gabriel-ruffo/skittle-sorter/tube.SLDPRT

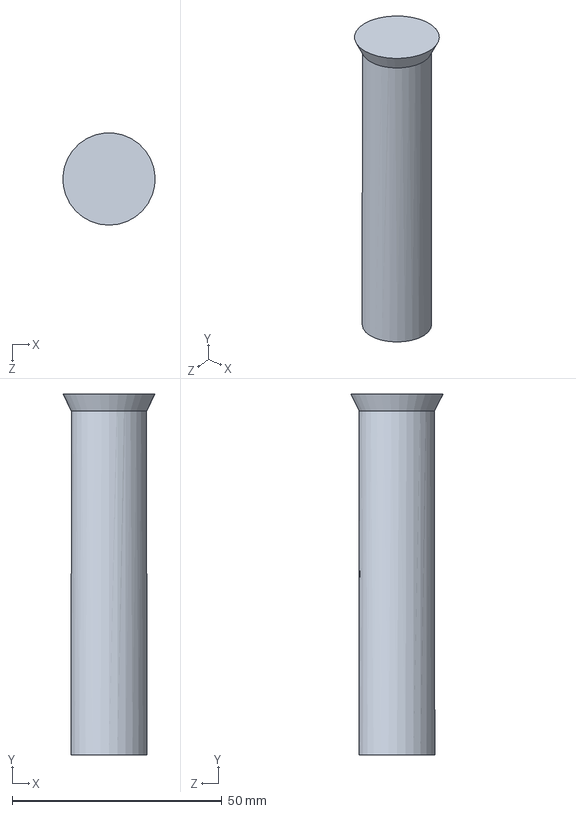
[picture p19: CAD file, 2020-01-24]
tube.SLDPRT
22.0 x 86.0 x 22.0 mm
