gabriel-ruffo/skittle-sorter/servoArmLong.SLDPRT

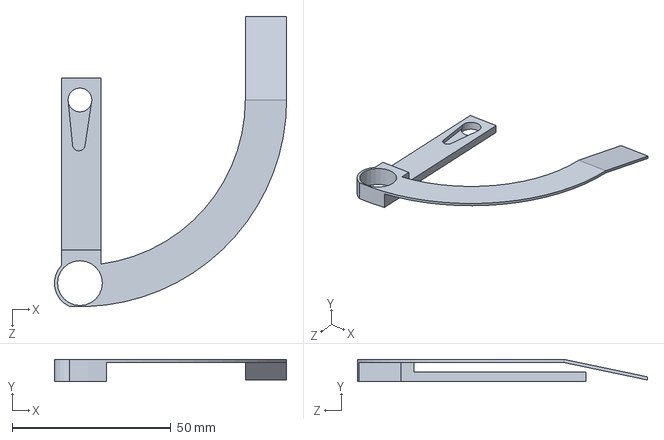
[picture p20: CAD file, 2020-01-24]
servoArmLong.SLDPRT
73.0 x 7.00 x 91.2 mm
