gabriel-ruffo/skittle-sorter/bottomPlateLong.SLDPRT

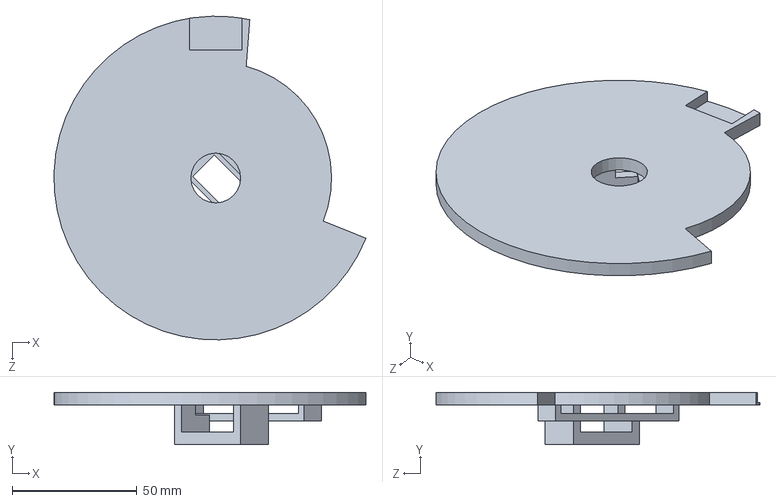
[picture p21: CAD file, 2020-01-24]
bottomPlateLong.SLDPRT
125.3 x 21.0 x 130.0 mm
