gabriel-ruffo/skittle-sorter/armHolder.SLDPRT

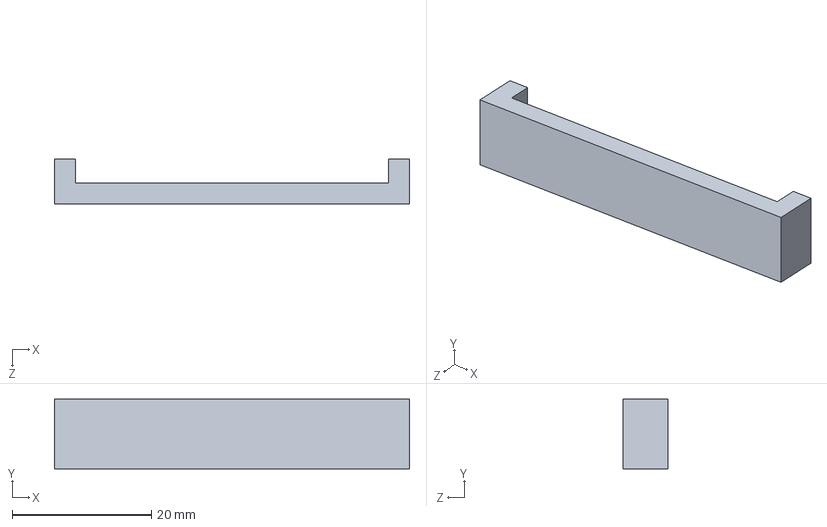
[picture p22: CAD file, 2020-01-24]
armHolder.SLDPRT
51.0 x 10.0 x 6.50 mm
